Queens-Rocket-Engineering-Team/prop-pandaV2/panda.kicad_pcb

## KiCad design panda.kicad_pcb (2025-11-02)

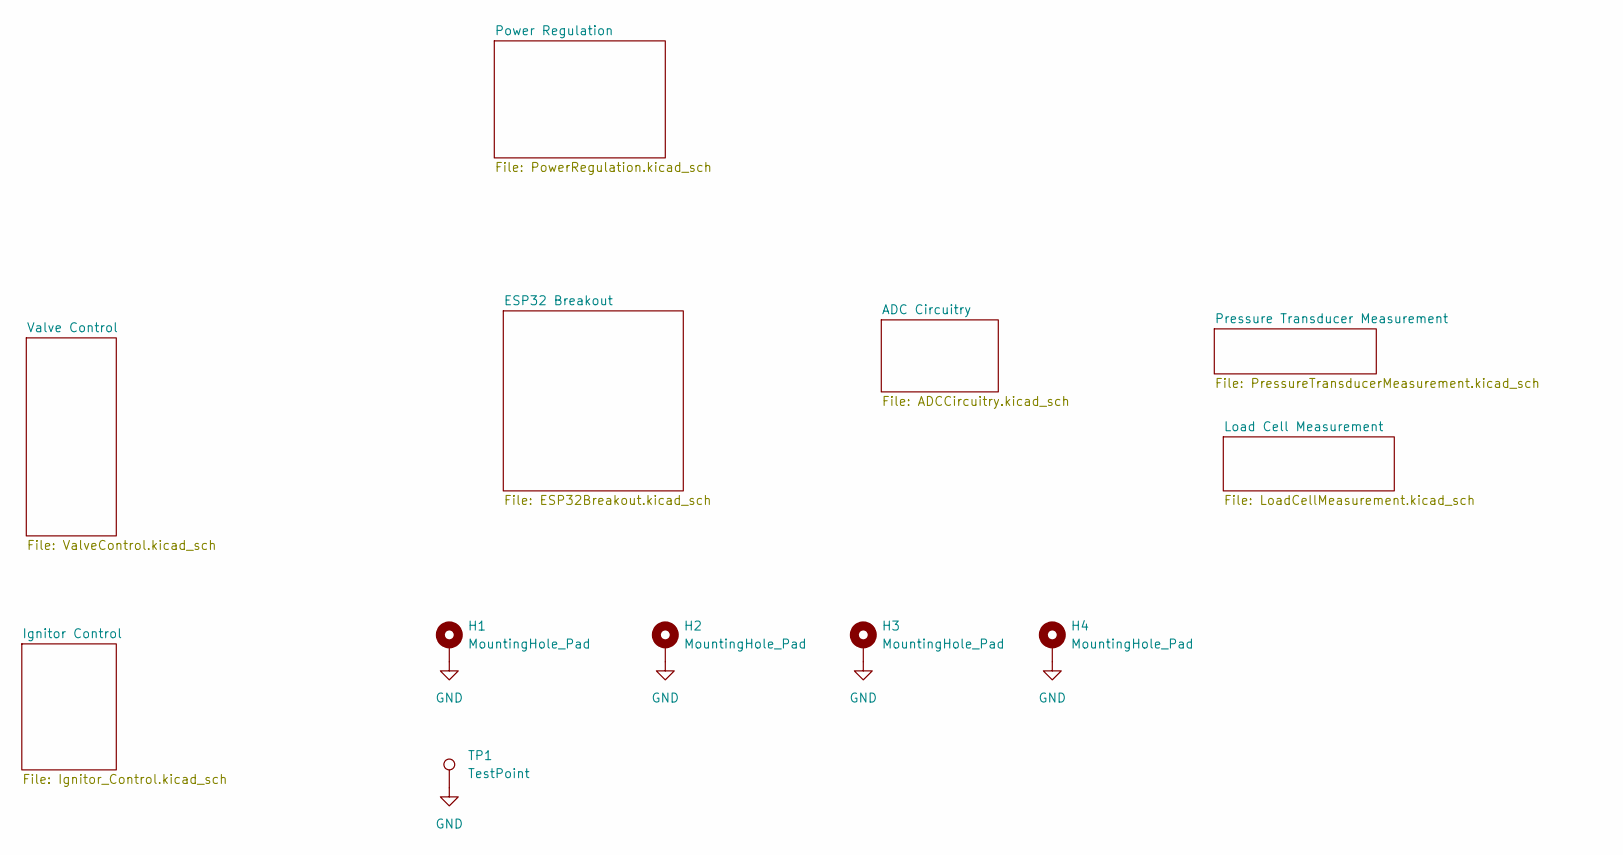
[picture p1: schematic panda.kicad_sch]

Parts:
H1, H2, H3, H4: MountingHole_Pad; MountingHole_3.2mm_M3_ISO7380_Pad
TP1: TestPoint; TestPoint_Loop_D2.50mm_Drill1.0mm

Connections:
GND: H1.1, H2.1, H3.1, H4.1, TP1.1; also elsewhere on the board

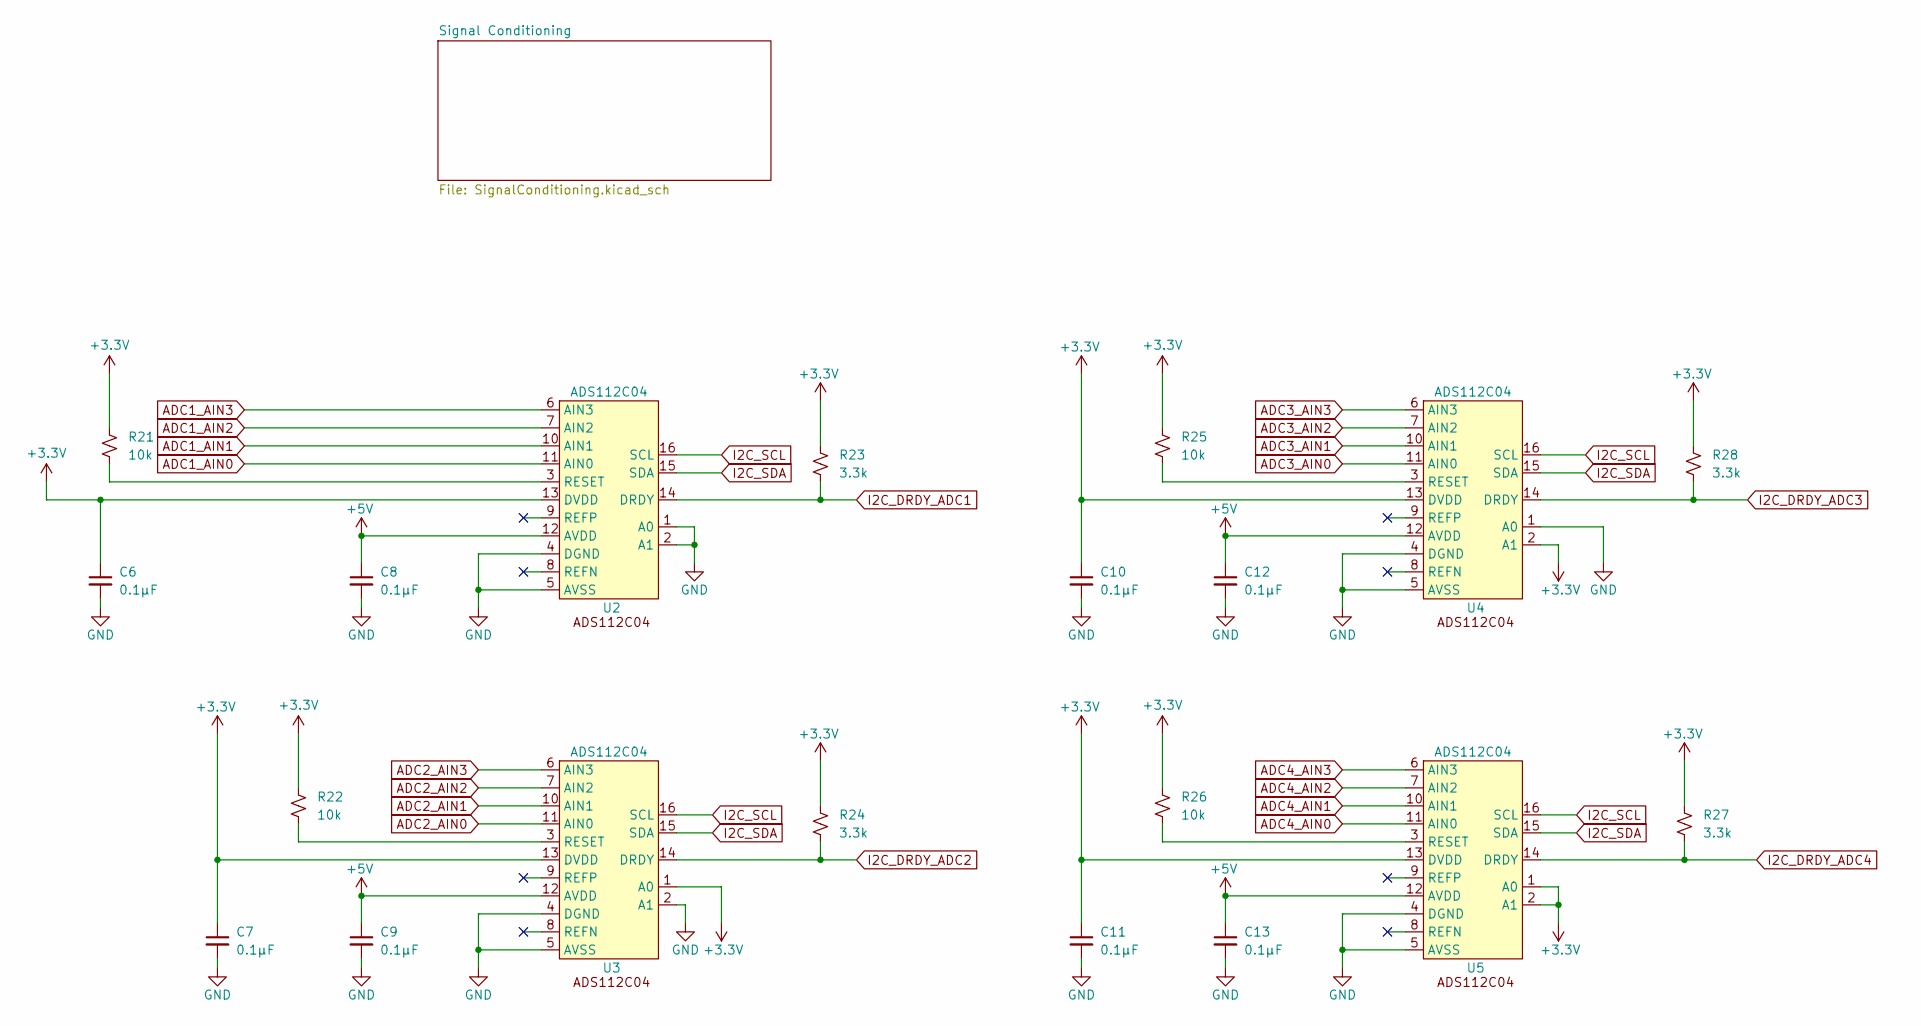
[picture p2: schematic ADCCircuitry.kicad_sch]

Parts:
C6, C7, C8, C9, C10, C11, C12, C13: 0.1μF; C_0402_1005Metric; MPN CL05B104KO5NNNC; LCSC C1525
R21, R22, R25, R26: 10k; R_0402_1005Metric; MPN 0402WGJ0103TCE; LCSC C25531
R23, R24, R27, R28: 3.3k; R_0402_1005Metric; MPN 0402WGF3301TCE; LCSC C25890
U2, U3, U4, U5: ADS112C04; TSSOP-16_4.4x5mm_P0.65mm; MPN ADS112C04IPWR; LCSC C701615

Connections:
+3.3V: C6.1, C7.1, C10.1, C11.1, R21.1, R22.1, R23.1, R24.1, R25.1, R26.1, R27.1, R28.1, U2.13 (DVDD), U3.1 (A0), U3.13 (DVDD), U4.2 (A1), U4.13 (DVDD), U5.1 (A0), U5.2 (A1), U5.13 (DVDD); also elsewhere on the board
+5V: C8.1, C9.1, C12.1, C13.1, U2.12 (AVDD), U3.12 (AVDD), U4.12 (AVDD), U5.12 (AVDD); also elsewhere on the board
ADC1_AIN0: U2.11 (AIN0); also elsewhere on the board
ADC1_AIN1: U2.10 (AIN1); also elsewhere on the board
ADC1_AIN2: U2.7 (AIN2); also elsewhere on the board
ADC1_AIN3: U2.6 (AIN3); also elsewhere on the board
ADC2_AIN0: U3.11 (AIN0); also elsewhere on the board
ADC2_AIN1: U3.10 (AIN1); also elsewhere on the board
ADC2_AIN2: U3.7 (AIN2); also elsewhere on the board
ADC2_AIN3: U3.6 (AIN3); also elsewhere on the board
ADC3_AIN0: U4.11 (AIN0); also elsewhere on the board
ADC3_AIN1: U4.10 (AIN1); also elsewhere on the board
ADC3_AIN2: U4.7 (AIN2); also elsewhere on the board
ADC3_AIN3: U4.6 (AIN3); also elsewhere on the board
ADC4_AIN0: U5.11 (AIN0); also elsewhere on the board
ADC4_AIN1: U5.10 (AIN1); also elsewhere on the board
ADC4_AIN2: U5.7 (AIN2); also elsewhere on the board
ADC4_AIN3: U5.6 (AIN3); also elsewhere on the board
GND: C6.2, C7.2, C8.2, C9.2, C10.2, C11.2, C12.2, C13.2, U2.1 (A0), U2.2 (A1), U2.4 (DGND), U2.5 (AVSS), U3.2 (A1), U3.4 (DGND), U3.5 (AVSS), U4.1 (A0), U4.4 (DGND), U4.5 (AVSS), U5.4 (DGND), U5.5 (AVSS); also elsewhere on the board
I2C_DRDY_ADC1: R23.2, U2.14 (DRDY); also elsewhere on the board
I2C_DRDY_ADC2: R24.2, U3.14 (DRDY); also elsewhere on the board
I2C_DRDY_ADC3: R28.2, U4.14 (DRDY); also elsewhere on the board
I2C_DRDY_ADC4: R27.2, U5.14 (DRDY); also elsewhere on the board
I2C_SCL: U2.16 (SCL), U3.16 (SCL), U4.16 (SCL), U5.16 (SCL); also elsewhere on the board
I2C_SDA: U2.15 (SDA), U3.15 (SDA), U4.15 (SDA), U5.15 (SDA); also elsewhere on the board
unnamed: R21.2, U2.3 (RESET)
unnamed: R22.2, U3.3 (RESET)
unnamed: R25.2, U4.3 (RESET)
unnamed: R26.2, U5.3 (RESET)

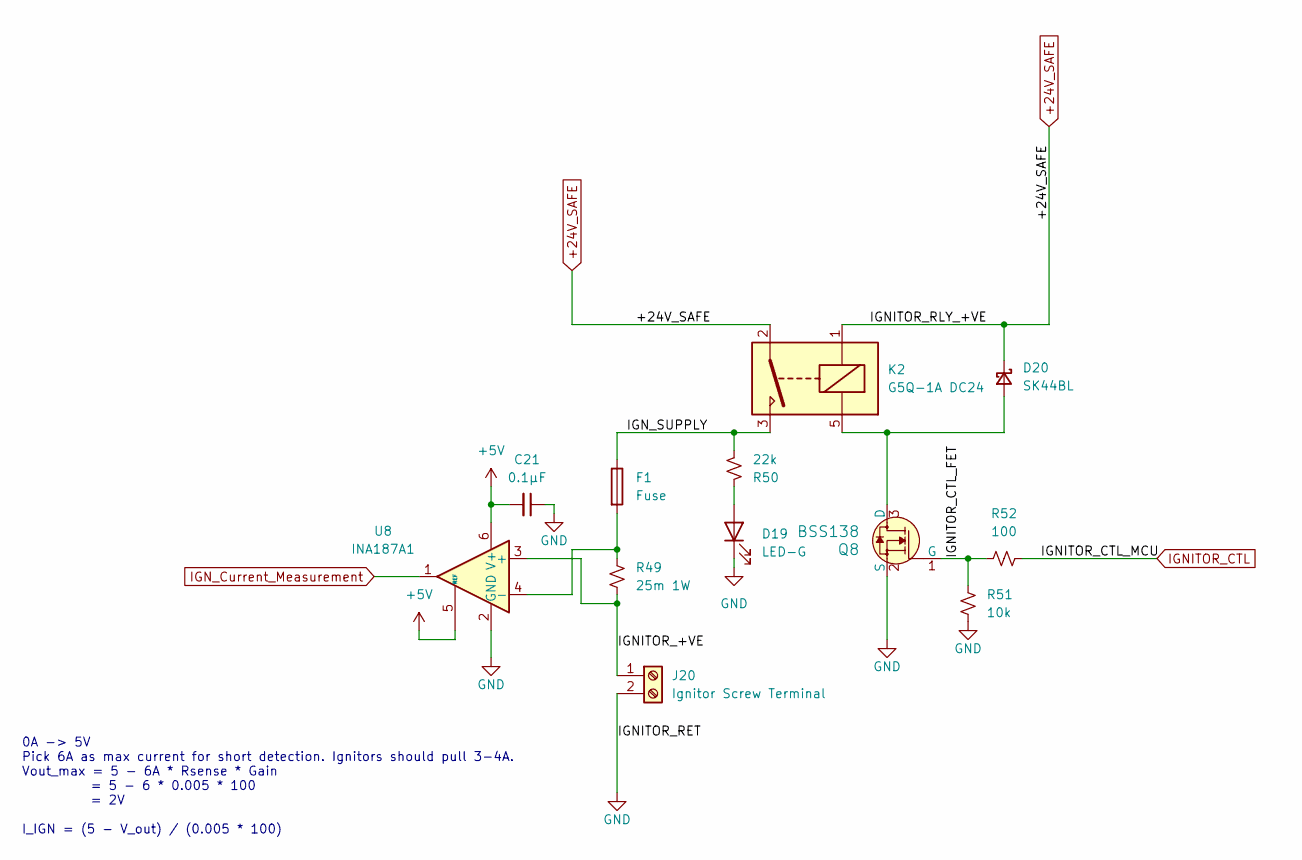
[picture p3: schematic Ignitor_Control.kicad_sch, Ignitor Control]

Parts:
C21: 0.1μF; C_0402_1005Metric; MPN CL05B104KO5NNNC; LCSC C1525
D19: LED-G; LED_0805_2012Metric; LCSC C2297
D20: SK44BL; D_SMB; MPN SK44BL-TP; LCSC C151740
F1: Fuse; Fuseholder_Blade_Mini_Keystone_3568
J20: Ignitor Screw Terminal; TerminalBlock_4Ucon_1x02_P3.50mm_Vertical; MPN OSTTE020104; Digikey PN ED2740-ND
K2: G5Q-1A DC24; Relay_SPST_Omron-G5Q-1A
Q8: BSS138; SOT-23-3; MPN BSS138; LCSC C8490
R49: 25m 1W; R_1206_3216Metric; LCSC C723507
R50: 22k; R_0402_1005Metric
R51: 10k; R_0402_1005Metric; MPN 0402WGJ0103TCE; LCSC C25531
R52: 100; R_0402_1005Metric; MPN 0402WGF1000TCE; LCSC C25076
U8: INA187A1; SOT-23-6

Connections:
+5V: C21.2, U8.5 (REF), U8.6 (V+); also elsewhere on the board
+24V_SAFE: D20.1 (K), K2.1, K2.2; also elsewhere on the board
/Ignitor Control/IGNITOR_+VE: J20.1, R49.2, U8.3 (+)
/Ignitor Control/IGNITOR_CTL_FET: Q8.1 (G), R51.1, R52.1
/Ignitor Control/IGN_SUPPLY: F1.1, K2.3, R50.2
GND: C21.1, D19.1 (K), J20.2, Q8.2 (S), R51.2, U8.2 (GND); also elsewhere on the board
IGNITOR_CTL: R52.2; also elsewhere on the board
IGN_Current_Measurement: U8.1; also elsewhere on the board
unnamed: D19.2 (A), R50.1
unnamed: D20.2 (A), K2.5, Q8.3 (D)
unnamed: F1.2, R49.1, U8.4 (-)

Notes on the sheet:
0A -> 5V Pick 6A as max current for short detection. Ignitors should pull 3-4A. Vout_max = 5 - 6A * Rsense * Gain = 5 - 6 * 0.005 * 100 = 2V I_IGN = (5 - V_out) / (0.005 * 100)

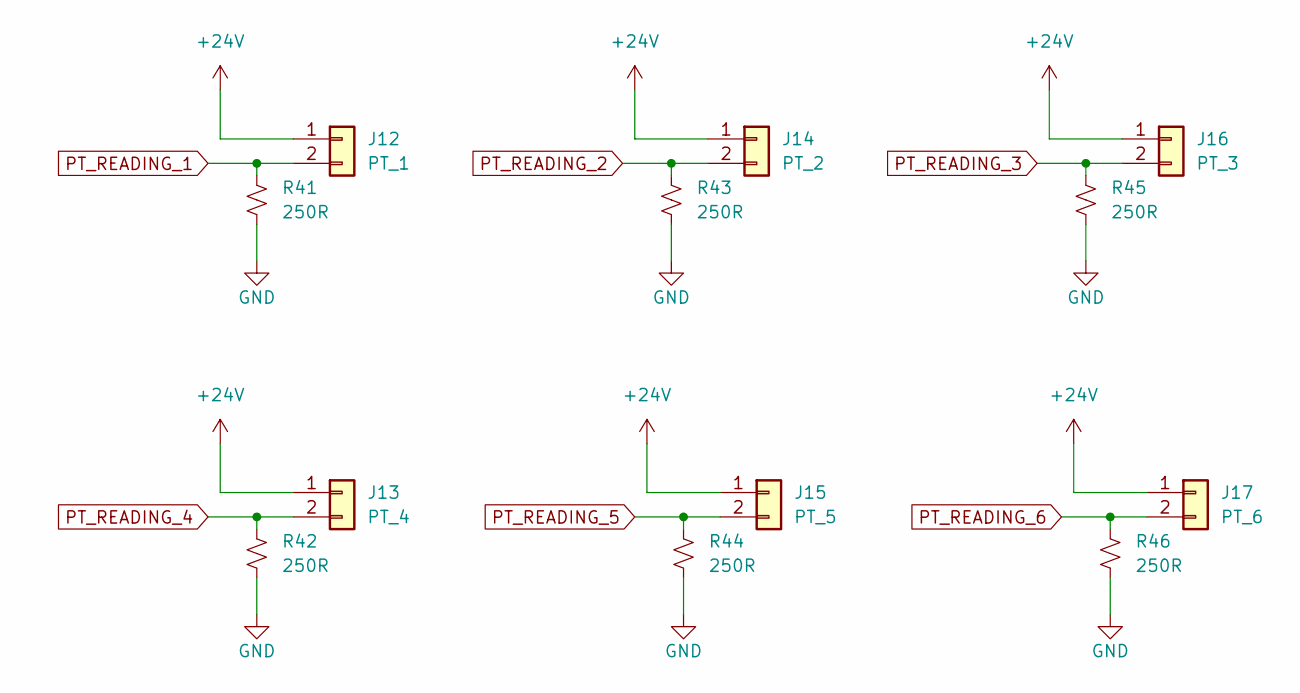
[picture p4: schematic PressureTransducerMeasurement.kicad_sch, Pressure Transducer Measurement]

Parts:
J12: PT_1; JST_XH_B2B-XH-A_1x02_P2.50mm_Vertical; MPN XH-2A; LCSC C20079
J13: PT_4; JST_XH_B2B-XH-A_1x02_P2.50mm_Vertical; MPN XH-2A; LCSC C20079
J14: PT_2; JST_XH_B2B-XH-A_1x02_P2.50mm_Vertical; MPN XH-2A; LCSC C20079
J15: PT_5; JST_XH_B2B-XH-A_1x02_P2.50mm_Vertical; MPN XH-2A; LCSC C20079
J16: PT_3; JST_XH_B2B-XH-A_1x02_P2.50mm_Vertical; MPN XH-2A; LCSC C20079
J17: PT_6; JST_XH_B2B-XH-A_1x02_P2.50mm_Vertical; MPN XH-2A; LCSC C20079
R41, R42, R43, R44, R45, R46: 250R; R_0603_1608Metric; MPN RT0603BRE07250RL; LCSC C861779

Connections:
+24V: J12.1, J13.1, J14.1, J15.1, J16.1, J17.1; also elsewhere on the board
GND: R41.2, R42.2, R43.2, R44.2, R45.2, R46.2; also elsewhere on the board
PT_READING_1: J12.2, R41.1; also elsewhere on the board
PT_READING_2: J14.2, R43.1; also elsewhere on the board
PT_READING_3: J16.2, R45.1; also elsewhere on the board
PT_READING_4: J13.2, R42.1; also elsewhere on the board
PT_READING_5: J15.2, R44.1; also elsewhere on the board
PT_READING_6: J17.2, R46.1; also elsewhere on the board

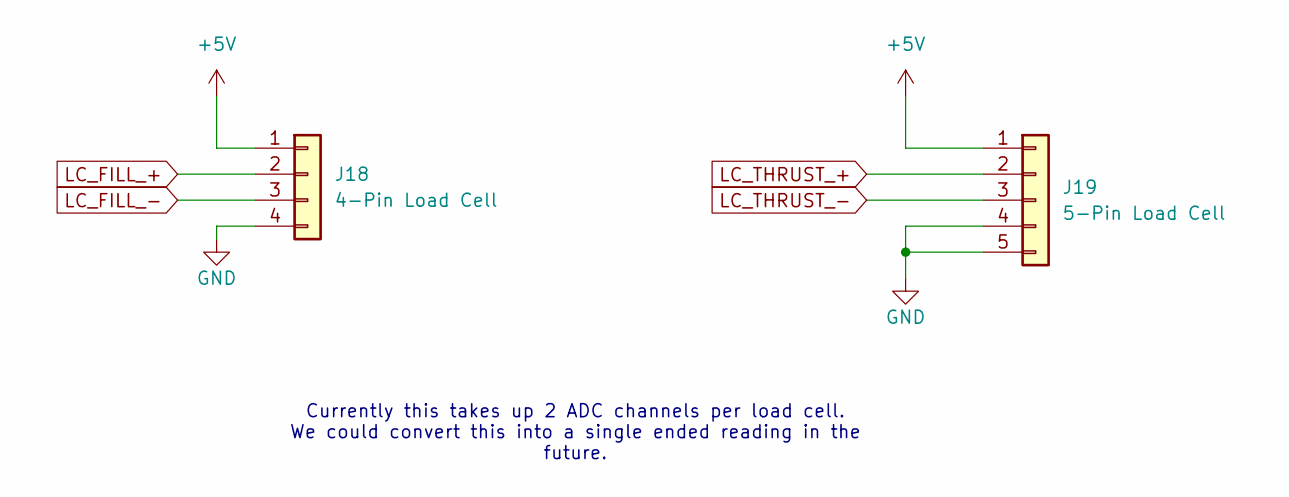
[picture p5: schematic LoadCellMeasurement.kicad_sch, Load Cell Measurement]

Parts:
J18: 4-Pin Load Cell; JST_XH_B4B-XH-A_1x04_P2.50mm_Vertical
J19: 5-Pin Load Cell; JST_XH_B5B-XH-A_1x05_P2.50mm_Vertical

Connections:
+5V: J18.1, J19.1; also elsewhere on the board
GND: J18.4, J19.4, J19.5; also elsewhere on the board
LC_FILL_+: J18.2; also elsewhere on the board
LC_FILL_-: J18.3; also elsewhere on the board
LC_THRUST_+: J19.2; also elsewhere on the board
LC_THRUST_-: J19.3; also elsewhere on the board

Notes on the sheet:
Currently this takes up 2 ADC channels per load cell. We could convert this into a single ended reading in the future.

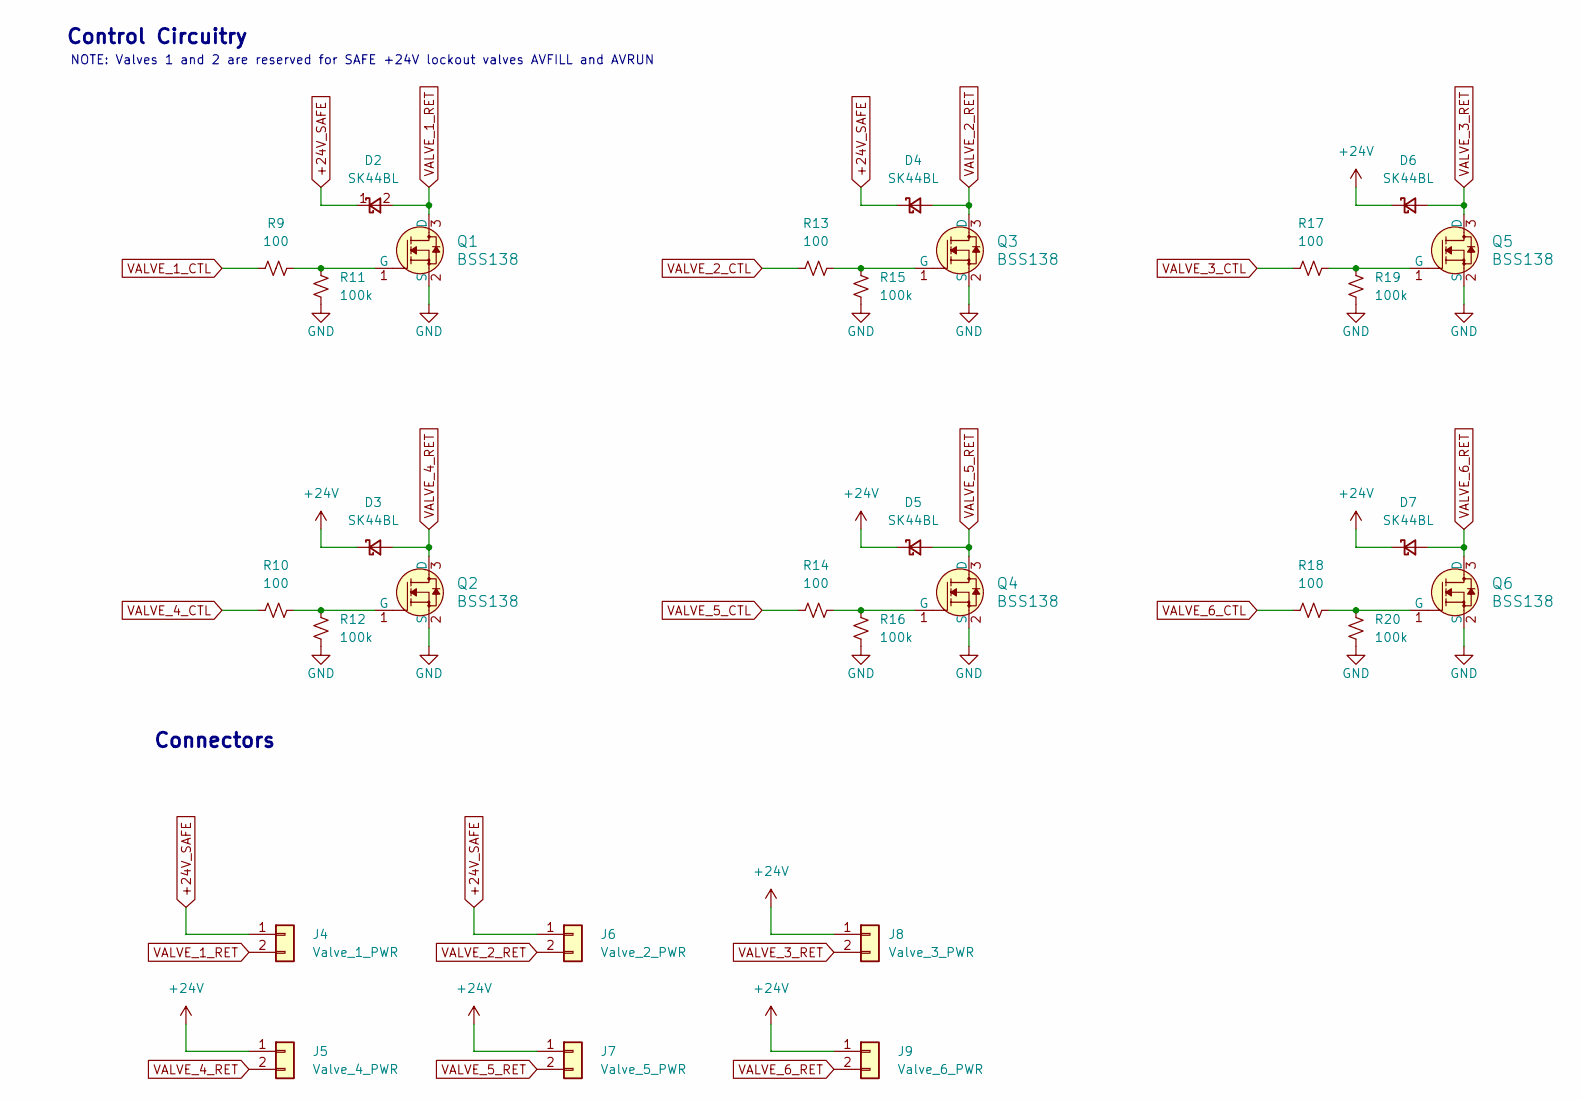
[picture p6: schematic ValveControl.kicad_sch, Valve Control]

Parts:
D2, D3, D4, D5, D6, D7: SK44BL; D_SMB; MPN SK44BL-TP; LCSC C151740
J4: Valve_1_PWR; JST_XH_B2B-XH-A_1x02_P2.50mm_Vertical; MPN XH-2A; LCSC C20079
J5: Valve_4_PWR; JST_XH_B2B-XH-A_1x02_P2.50mm_Vertical; MPN XH-2A; LCSC C20079
J6: Valve_2_PWR; JST_XH_B2B-XH-A_1x02_P2.50mm_Vertical; MPN XH-2A; LCSC C20079
J7: Valve_5_PWR; JST_XH_B2B-XH-A_1x02_P2.50mm_Vertical; MPN XH-2A; LCSC C20079
J8: Valve_3_PWR; JST_XH_B2B-XH-A_1x02_P2.50mm_Vertical; MPN XH-2A; LCSC C20079
J9: Valve_6_PWR; JST_XH_B2B-XH-A_1x02_P2.50mm_Vertical; MPN XH-2A; LCSC C20079
Q1, Q2, Q3, Q4: BSS138; SOT-23-3; MPN BSS138; LCSC C8490
Q5, Q6: BSS138; SOT-23-3; MPN BSS138; Digi-Key_PN BSS138CT-ND
R9, R10, R13, R14, R17, R18: 100; R_0402_1005Metric; MPN 0402WGF1000TCE; LCSC C25076
R11, R12, R15, R16, R19, R20: 100k; R_0402_1005Metric; MPN 0402WGJ0104TCE; LCSC C25530

Connections:
+24V: D3.1 (K), D5.1 (K), D6.1 (K), D7.1 (K), J5.1, J7.1, J8.1, J9.1; also elsewhere on the board
+24V_SAFE: D2.1 (K), D4.1 (K), J4.1, J6.1; also elsewhere on the board
GND: Q1.2 (S), Q2.2 (S), Q3.2 (S), Q4.2 (S), Q5.2 (S), Q6.2 (S), R11.2, R12.2, R15.2, R16.2, R19.2, R20.2; also elsewhere on the board
unnamed: Q1.1 (G), R9.2, R11.1
unnamed: Q2.1 (G), R10.2, R12.1
unnamed: Q3.1 (G), R13.2, R15.1
unnamed: Q4.1 (G), R14.2, R16.1
unnamed: Q5.1 (G), R17.2, R19.1
unnamed: Q6.1 (G), R18.2, R20.1
VALVE_1_CTL: R9.1; also elsewhere on the board
VALVE_1_RET: D2.2 (A), J4.2, Q1.3 (D)
VALVE_2_CTL: R13.1; also elsewhere on the board
VALVE_2_RET: D4.2 (A), J6.2, Q3.3 (D)
VALVE_3_CTL: R17.1; also elsewhere on the board
VALVE_3_RET: D6.2 (A), J8.2, Q5.3 (D)
VALVE_4_CTL: R10.1; also elsewhere on the board
VALVE_4_RET: D3.2 (A), J5.2, Q2.3 (D)
VALVE_5_CTL: R14.1; also elsewhere on the board
VALVE_5_RET: D5.2 (A), J7.2, Q4.3 (D)
VALVE_6_CTL: R18.1; also elsewhere on the board
VALVE_6_RET: D7.2 (A), J9.2, Q6.3 (D)

Notes on the sheet:
NOTE: Valves 1 and 2 are reserved for SAFE +24V lockout valves AVFILL and AVRUN
Control Circuitry
Connectors

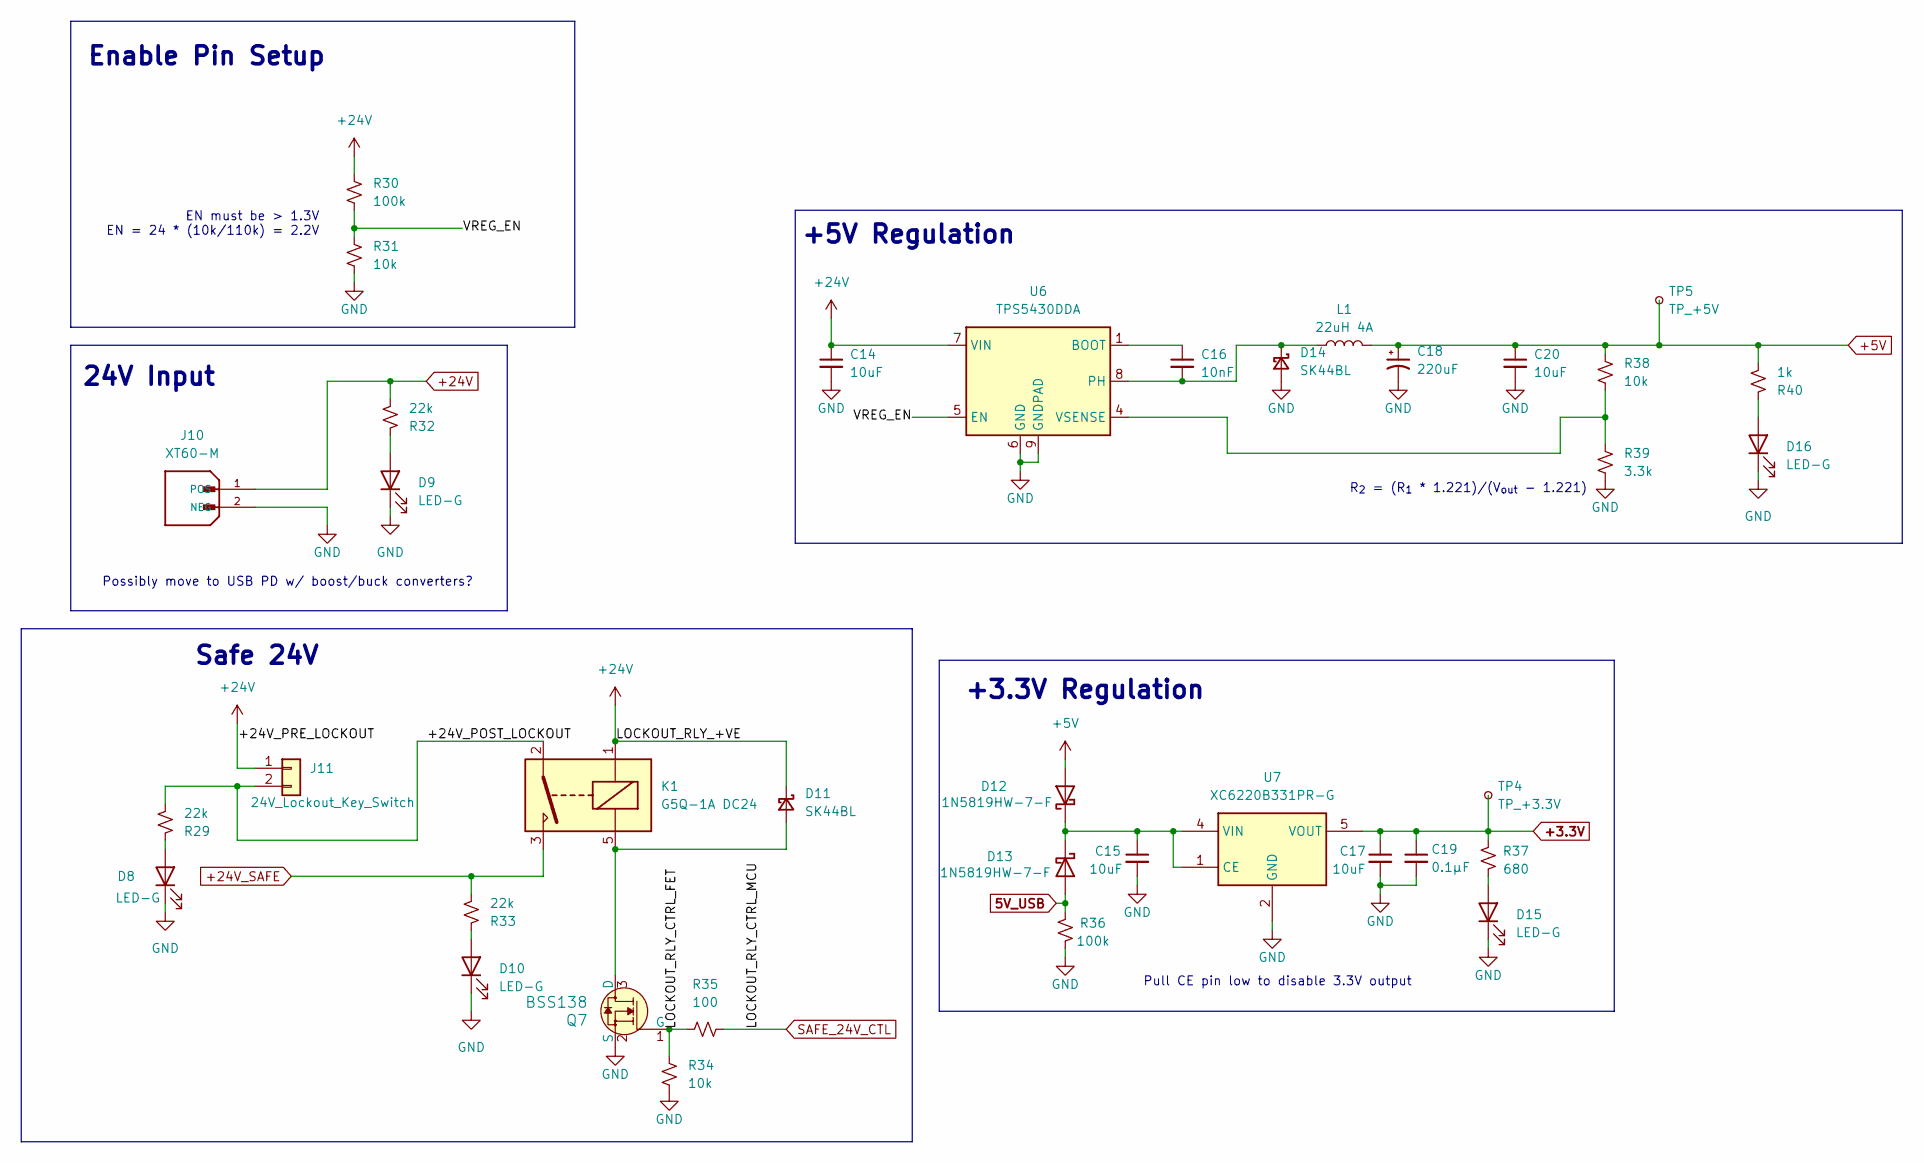
[picture p7: schematic PowerRegulation.kicad_sch, Power Distribution]

Parts:
C14, C15, C17, C20: 10uF; C_1206_3216Metric; Voltage 50V; LCSC C13585
C16: 10nF; C_0402_1005Metric; MPN 0402B103K500NT; LCSC C1524
C18: 220uF; CP_Elec_8x10.5; LCSC C3340
C19: 0.1μF; C_0402_1005Metric; MPN CL05B104KO5NNNC; LCSC C1525
D8, D9, D10, D15, D16: LED-G; LED_0805_2012Metric; LCSC C2297
D11, D14: SK44BL; D_SMB; MPN SK44BL-TP; LCSC C151740
D12, D13: 1N5819HW-7-F; D_SOD-123
J10: XT60-M; AMASS_XT60PW-F_1x02_P7.20mm_Horizontal; PARTREV V1.2
J11: 24V_Lockout_Key_Switch; JST_XH_B2B-XH-A_1x02_P2.50mm_Vertical; MPN XH-2A; LCSC C20079
K1: G5Q-1A DC24; Relay_SPST_Omron-G5Q-1A
L1: 22uH 4A; L_12.5x12.5mm_SXNSMDRS1275; LCSC C163684
Q7: BSS138; SOT-23-3; MPN BSS138; LCSC C8490
R29, R32, R33: 22k; R_0402_1005Metric
R30: 100k; R_0402_1005Metric; MPN 0402WGJ0104TCE; LCSC C25530
R31, R34, R38: 10k; R_0402_1005Metric; MPN 0402WGJ0103TCE; LCSC C25531
R35: 100; R_0402_1005Metric; MPN 0402WGF1000TCE; LCSC C25076
R36: 100k; R_0402_1005Metric
R37: 680; R_0402_1005Metric
R39: 3.3k; R_0402_1005Metric; MPN 0402WGF3301TCE; LCSC C25890
R40: 1k; R_0402_1005Metric
TP4: TP_+3.3V; TestPoint_Pad_D1.0mm
TP5: TP_+5V; TestPoint_Pad_D1.0mm
U6: TPS5430DDA; TI_SO-PowerPAD-8_ThermalVias; LCSC C9864
U7: XC6220B331PR-G; SOT-89-5

Connections:
5V_USB: D13.2 (A), R36.2; also elsewhere on the board
+3.3V: C17.1, C19.1, R37.2, TP4.1, U7.5 (VOUT); also elsewhere on the board
+5V: C18.1, C20.1, D12.2 (A), L1.2, R38.1, R40.2, TP5.1; also elsewhere on the board
+24V: C14.1, D11.1 (K), J10.1 (POS), J11.1, K1.1, R30.1, R32.2, U6.7 (VIN); also elsewhere on the board
+24V_SAFE: K1.3, R33.2; also elsewhere on the board
/Power Regulation/+24V_POST_LOCKOUT: J11.2, K1.2, R29.2
/Power Regulation/LOCKOUT_RLY_CTRL_FET: Q7.1 (G), R34.1, R35.1
/Power Regulation/VREG_EN: R30.2, R31.1, U6.5 (EN)
GND: C14.2, C15.2, C17.2, C18.2, C19.2, C20.2, D8.1 (K), D9.1 (K), D10.1 (K), D14.2 (A), D15.1 (K), D16.1 (K), J10.2 (NEG), Q7.2 (S), R31.2, R34.2, R36.1, R39.2, U6.6 (GND), U6.9 (GNDPAD), U7.2 (GND); also elsewhere on the board
unnamed: D8.2 (A), R29.1
unnamed: D9.2 (A), R32.1
unnamed: D10.2 (A), R33.1
unnamed: D11.2 (A), K1.5, Q7.3 (D)
unnamed: C15.1, D12.1 (K), D13.1 (K), U7.1 (CE), U7.4 (VIN)
unnamed: C16.2, D14.1 (K), L1.1, U6.8 (PH)
unnamed: D15.2 (A), R37.1
unnamed: D16.2 (A), R40.1
unnamed: C16.1, U6.1 (BOOT)
unnamed: R38.2, R39.1, U6.4 (VSENSE)
SAFE_24V_CTL: R35.2; also elsewhere on the board

Notes on the sheet:
EN must be > 1.3V EN = 24 * (10k/110k) = 2.2V
Possibly move to USB PD w/ boost/buck converters?
+5V Regulation
R_{2} = (R_{1} * 1.221)/(V_{out} - 1.221)
+3.3V Regulation
Enable Pin Setup
Pull CE pin low to disable 3.3V output
24V Input
Safe 24V

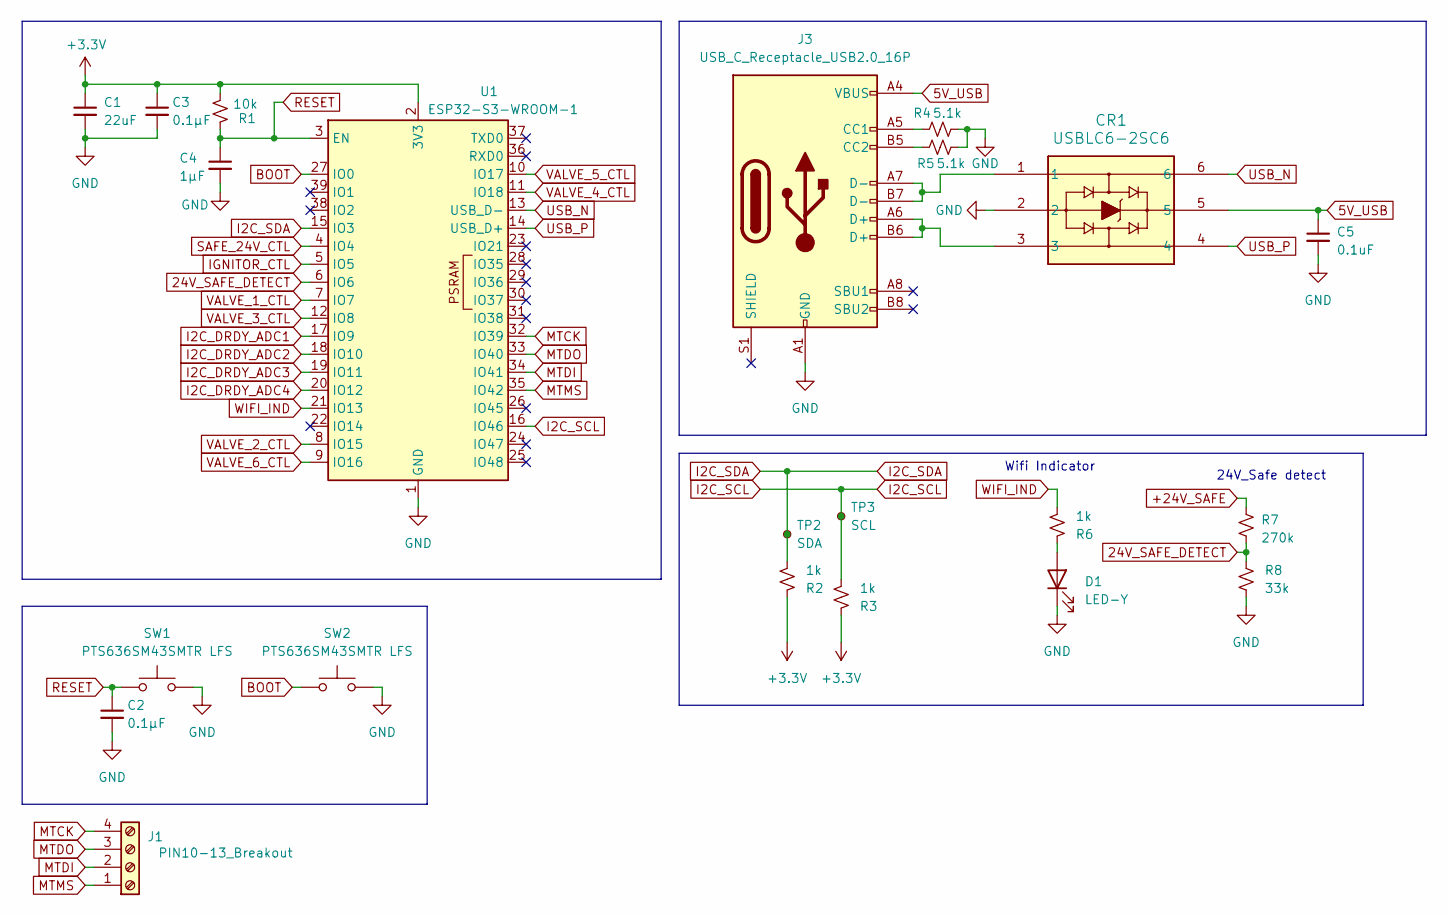
[picture p8: schematic ESP32Breakout.kicad_sch, ESP32 Interface]

Parts:
C1: 22uF; C_1206_3216Metric; Voltage 50V; LCSC C13585
C2, C3: 0.1μF; C_0402_1005Metric; MPN CL05B104KO5NNNC; LCSC C1525
C4: 1μF; C_0402_1005Metric; MPN CL05B104KO5NNNC; LCSC C1525
C5: 0.1uF; C_0402_1005Metric; Voltage 50V; LCSC C13585
CR1: USBLC6-2SC6; SOT-23-6
D1: LED-Y; LED_0805_2012Metric; LCSC C2296
J1: PIN10-13_Breakout; TerminalBlock_Xinya_XY308-2.54-4P_1x04_P2.54mm_Horizontal; Digikey PN ED10563-ND
J3: USB_C_Receptacle_USB2.0_16P; USB_C_Receptacle_HCTL_HC-TYPE-C-16P-01A
R1: 10k; R_0402_1005Metric
R2, R3, R6: 1k; R_0402_1005Metric
R4, R5: 5.1k; R_0402_1005Metric
R7: 270k; R_0402_1005Metric
R8: 33k; R_0402_1005Metric
SW1, SW2: PTS636SM43SMTR LFS; SW_Tactile_SPST_NO_Straight_CK_PTS636Sx25SMTRLFS
TP2: SDA; TestPoint_Pad_D1.5mm
TP3: SCL; TestPoint_Pad_D1.5mm
U1: ESP32-S3-WROOM-1

Connections:
5V_USB: C5.1, CR1.5, J3.A4 (VBUS), J3.A9 (VBUS), J3.B4 (VBUS), J3.B9 (VBUS); also elsewhere on the board
24V_SAFE_DETECT: R7.2, R8.1, U1.6 (IO6)
+3.3V: C1.1, C3.1, R1.2, R2.1, R3.1, U1.2 (3V3); also elsewhere on the board
+24V_SAFE: R7.1; also elsewhere on the board
BOOT: SW2.1, U1.27 (IO0)
GND: C1.2, C2.2, C3.2, C4.2, C5.2, CR1.2, D1.1 (K), J3.A1 (GND), J3.A12 (GND), J3.B1 (GND), J3.B12 (GND), R4.2, R5.2, R8.2, SW1.2, SW2.2, U1.1 (GND), U1.40 (GND), U1.41 (GND); also elsewhere on the board
I2C_DRDY_ADC1: U1.17 (IO9); also elsewhere on the board
I2C_DRDY_ADC2: U1.18 (IO10); also elsewhere on the board
I2C_DRDY_ADC3: U1.19 (IO11); also elsewhere on the board
I2C_DRDY_ADC4: U1.20 (IO12); also elsewhere on the board
I2C_SCL: R3.2, TP3.1, U1.16 (IO46); also elsewhere on the board
I2C_SDA: R2.2, TP2.1, U1.15 (IO3); also elsewhere on the board
IGNITOR_CTL: U1.5 (IO5); also elsewhere on the board
MTCK: J1.4, U1.32 (IO39)
MTDI: J1.2, U1.34 (IO41)
MTDO: J1.3, U1.33 (IO40)
MTMS: J1.1, U1.35 (IO42)
unnamed: CR1.1, J3.A7 (D-), J3.B7 (D-)
unnamed: CR1.3, J3.A6 (D+), J3.B6 (D+)
unnamed: D1.2 (A), R6.1
unnamed: J3.A5 (CC1), R4.1
unnamed: J3.B5 (CC2), R5.1
RESET: C2.1, C4.1, R1.1, SW1.1, U1.3 (EN)
SAFE_24V_CTL: U1.4 (IO4); also elsewhere on the board
USB_N: CR1.6, U1.13 (USB_D-)
USB_P: CR1.4, U1.14 (USB_D+)
VALVE_1_CTL: U1.7 (IO7); also elsewhere on the board
VALVE_2_CTL: U1.8 (IO15); also elsewhere on the board
VALVE_3_CTL: U1.12 (IO8); also elsewhere on the board
VALVE_4_CTL: U1.11 (IO18); also elsewhere on the board
VALVE_5_CTL: U1.10 (IO17); also elsewhere on the board
VALVE_6_CTL: U1.9 (IO16); also elsewhere on the board
WIFI_IND: R6.2, U1.21 (IO13)

Notes on the sheet:
Wifi Indicator
24V_Safe detect

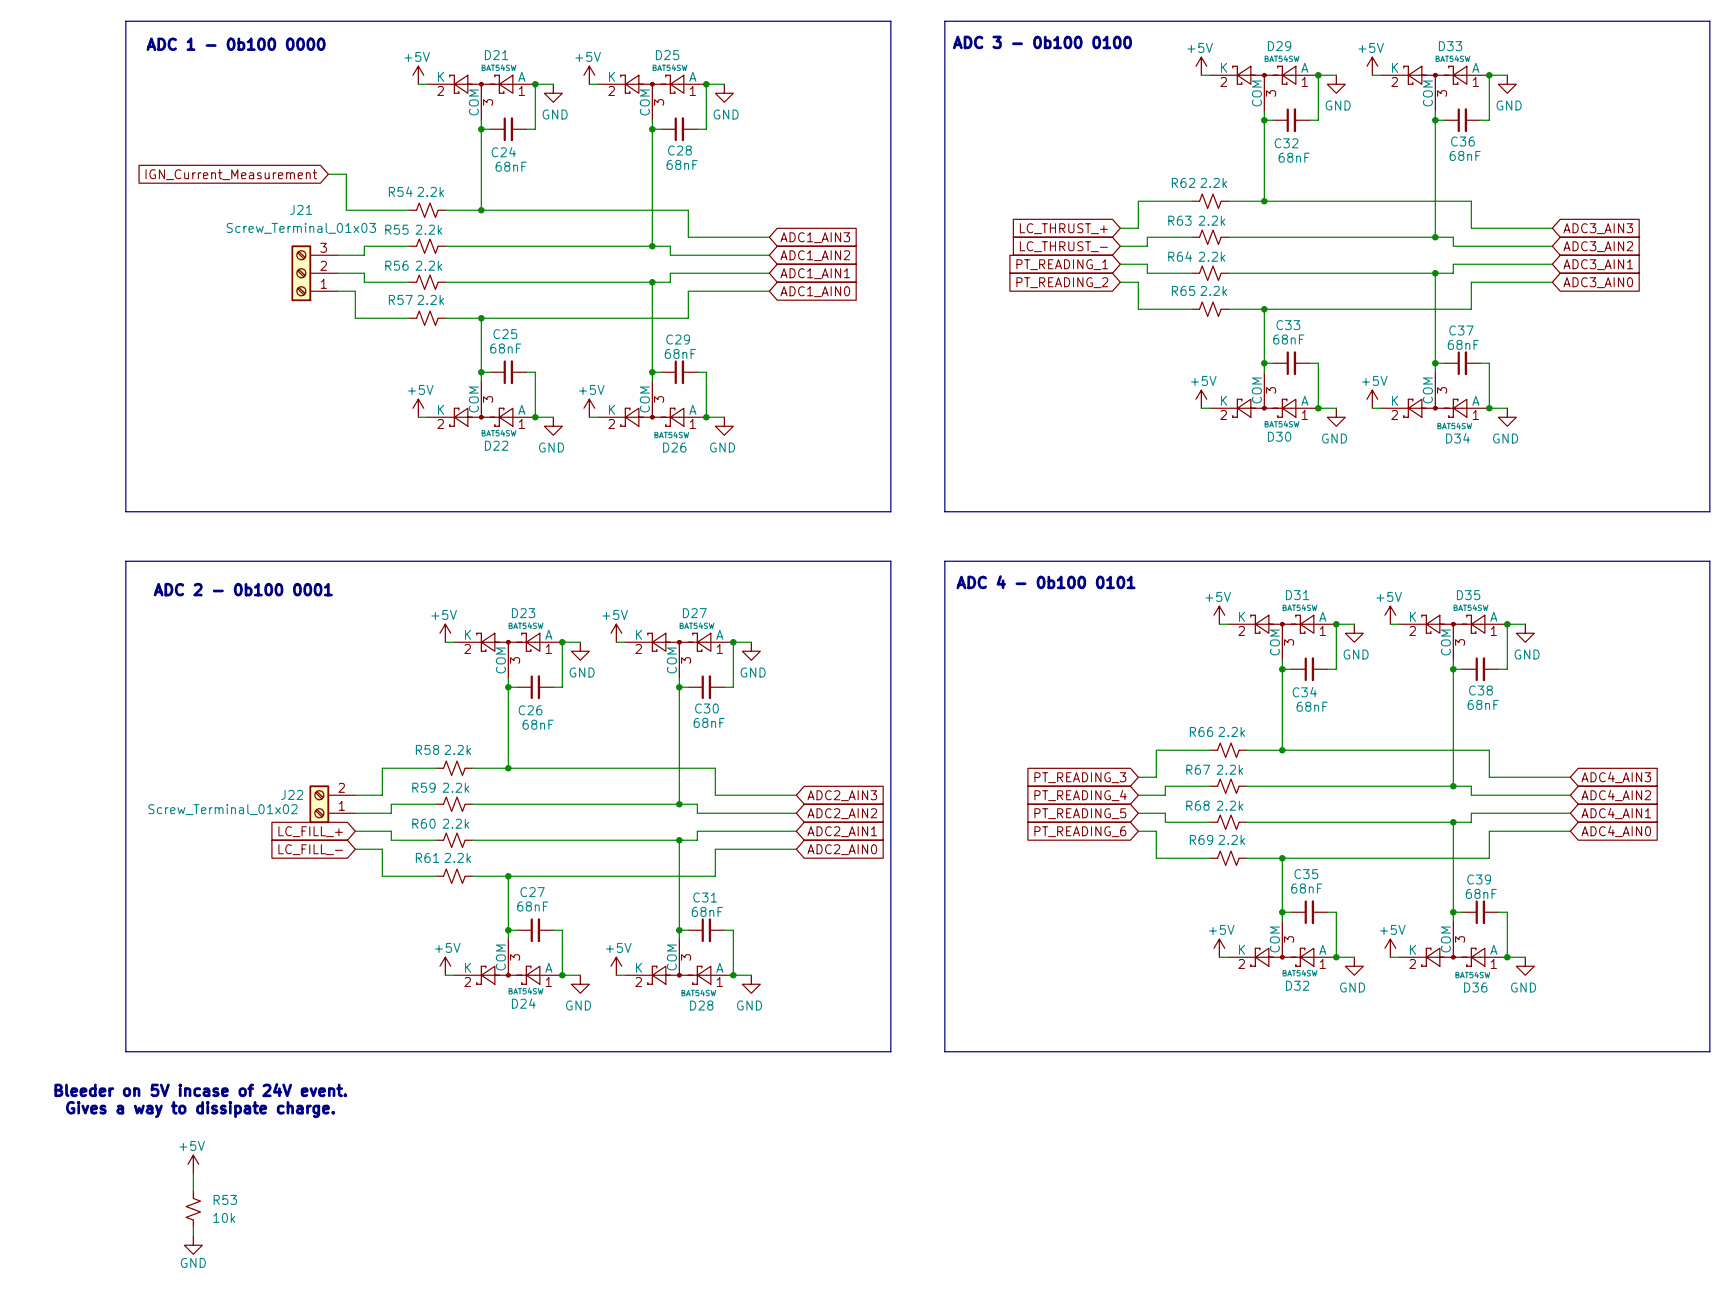
[picture p9: schematic SignalConditioning.kicad_sch]

Parts:
C24, C25, C26, C27, C28, C29, C30, C31, C32, C33, C34, C35, C36, C37, C38, C39: 68nF; C_0805_2012Metric
D21, D22, D23, D24, D25, D26, D27, D28, D29, D30, D31, D32, D33, D34, D35, D36: BAT54SW; SOT-323_SC-70
J21: Screw_Terminal_01x03; TerminalBlock_Xinya_XY308-2.54-3P_1x03_P2.54mm_Horizontal
J22: Screw_Terminal_01x02; TerminalBlock_Xinya_XY308-2.54-2P_1x02_P2.54mm_Horizontal
R53: 10k; R_0402_1005Metric; MPN 0402WGJ0103TCE; LCSC C25531
R54, R55, R56, R57, R58, R59, R60, R61, R62, R63, R64, R65, R66, R67, R68, R69: 2.2k; R_0402_1005Metric

Connections:
+5V: D21.2 (K), D22.2 (K), D23.2 (K), D24.2 (K), D25.2 (K), D26.2 (K), D27.2 (K), D28.2 (K), D29.2 (K), D30.2 (K), D31.2 (K), D32.2 (K), D33.2 (K), D34.2 (K), D35.2 (K), D36.2 (K), R53.1; also elsewhere on the board
ADC1_AIN0: C25.1, D22.3 (COM), R57.2; also elsewhere on the board
ADC1_AIN1: C29.1, D26.3 (COM), R56.2; also elsewhere on the board
ADC1_AIN2: C28.1, D25.3 (COM), R55.2; also elsewhere on the board
ADC1_AIN3: C24.1, D21.3 (COM), R54.2; also elsewhere on the board
ADC2_AIN0: C27.1, D24.3 (COM), R61.2; also elsewhere on the board
ADC2_AIN1: C31.1, D28.3 (COM), R60.2; also elsewhere on the board
ADC2_AIN2: C30.1, D27.3 (COM), R59.2; also elsewhere on the board
ADC2_AIN3: C26.1, D23.3 (COM), R58.2; also elsewhere on the board
ADC3_AIN0: C33.1, D30.3 (COM), R65.2; also elsewhere on the board
ADC3_AIN1: C37.1, D34.3 (COM), R64.2; also elsewhere on the board
ADC3_AIN2: C36.1, D33.3 (COM), R63.2; also elsewhere on the board
ADC3_AIN3: C32.1, D29.3 (COM), R62.2; also elsewhere on the board
ADC4_AIN0: C35.1, D32.3 (COM), R69.2; also elsewhere on the board
ADC4_AIN1: C39.1, D36.3 (COM), R68.2; also elsewhere on the board
ADC4_AIN2: C38.1, D35.3 (COM), R67.2; also elsewhere on the board
ADC4_AIN3: C34.1, D31.3 (COM), R66.2; also elsewhere on the board
GND: C24.2, C25.2, C26.2, C27.2, C28.2, C29.2, C30.2, C31.2, C32.2, C33.2, C34.2, C35.2, C36.2, C37.2, C38.2, C39.2, D21.1 (A), D22.1 (A), D23.1 (A), D24.1 (A), D25.1 (A), D26.1 (A), D27.1 (A), D28.1 (A), D29.1 (A), D30.1 (A), D31.1 (A), D32.1 (A), D33.1 (A), D34.1 (A), D35.1 (A), D36.1 (A), R53.2; also elsewhere on the board
IGN_Current_Measurement: R54.1; also elsewhere on the board
LC_FILL_+: R60.1; also elsewhere on the board
LC_FILL_-: R61.1; also elsewhere on the board
LC_THRUST_+: R62.1; also elsewhere on the board
LC_THRUST_-: R63.1; also elsewhere on the board
unnamed: J21.1, R57.1
unnamed: J21.2, R56.1
unnamed: J21.3, R55.1
unnamed: J22.1, R59.1
unnamed: J22.2, R58.1
PT_READING_1: R64.1; also elsewhere on the board
PT_READING_2: R65.1; also elsewhere on the board
PT_READING_3: R66.1; also elsewhere on the board
PT_READING_4: R67.1; also elsewhere on the board
PT_READING_5: R68.1; also elsewhere on the board
PT_READING_6: R69.1; also elsewhere on the board

Notes on the sheet:
ADC 3 - 0b100 0100
ADC 2 - 0b100 0001
ADC 4 - 0b100 0101
Bleeder on 5V incase of 24V event. Gives a way to dissipate charge.
ADC 1 - 0b100 0000
