Queens-Rocket-Engineering-Team/prop-pandaV2/panda.kicad_pcb

## KiCad design panda.kicad_pcb (continued)

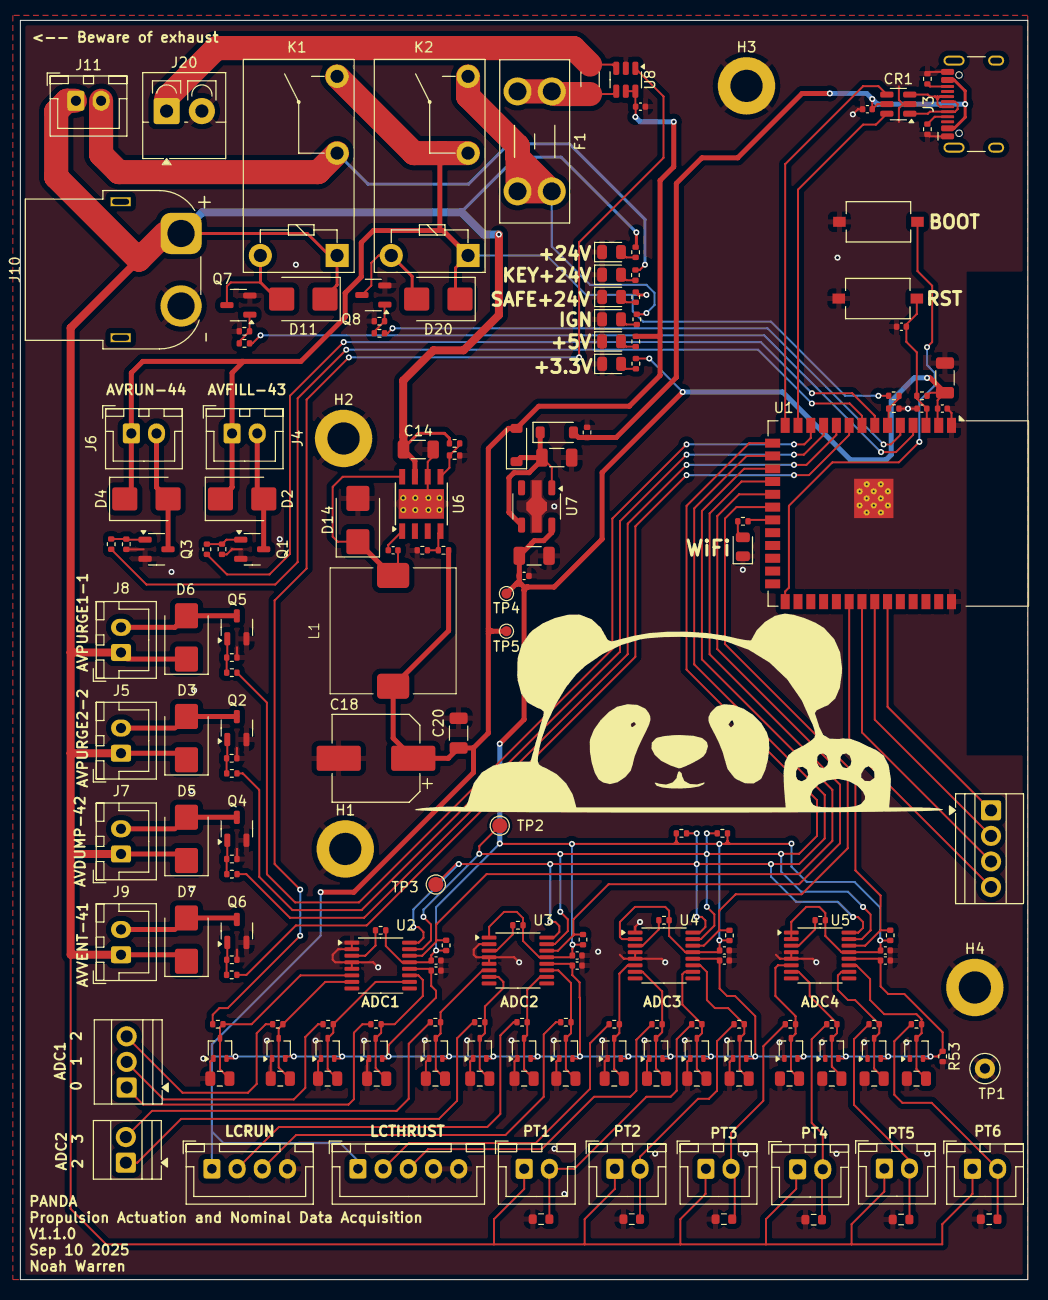
[picture p10: board panda.kicad_pcb from above]

Board: 2 copper layers, 100.0 x 125.0 mm, 191 parts (0 on the bottom side), 102 nets.
