Queens-Rocket-Engineering-Team/prop-pandaV2/(commit log)

2025-07-27 Add power regulation schematic
    [PowerRegulation.kicad_sch, nexus.kicad_sch]
2025-07-27 Add valve control
    [ESP32Breakout.kicad_sch, LoadCellMeasurement.kicad_sch, PowerRegulation.kicad_sch, PressureTransducerMeasurement.kicad_sch, ThermocoupleMeasurement.kicad_sch, nexus.kicad_sch]
2025-07-27 Add SAFE +24V
    [ADCCircuitry.kicad_sch, LoadCellMeasurement.kicad_sch, PressureTransducerMeasurement.kicad_sch, ThermocoupleMeasurement.kicad_sch, ValveControl.kicad_sch]
2025-07-28 Add load cell inputs
    [ADCCircuitry.kicad_sch, ESP32Breakout.kicad_sch, Ignitor_Control.kicad_sch, LoadCellMeasurement.kicad_sch, PowerRegulation.kicad_sch, PressureTransducerMeasurement.kicad_sch, ThermocoupleMeasurement.kicad_sch, ValveControl.kicad_sch]
2025-07-28 v0.1 sch. Add devkit c1 footprint
    [ADCCircuitry.kicad_sch, ESP32Breakout.kicad_sch, LoadCellMeasurement.kicad_sch, PowerRegulation.kicad_sch, PressureTransducerMeasurement.kicad_sch, nexus.kicad_pcb]
2025-07-28 Add all footprints
    [ADCCircuitry.kicad_sch, Ignitor_Control.kicad_sch, PowerRegulation.kicad_sch]
2025-07-29 Almost done routing
    [ADCCircuitry.kicad_sch, ESP32Breakout.kicad_sch, Ignitor_Control.kicad_sch, PowerRegulation.kicad_sch, PressureTransducerMeasurement.kicad_sch, nexus.kicad_pcb]
2025-07-29 Fix J5
    [PowerRegulation.kicad_sch, nexus.kicad_pcb]
2025-07-30 routing broken
    [ADCCircuitry.kicad_sch, ESP32Breakout.kicad_sch, Ignitor_Control.kicad_sch, LoadCellMeasurement.kicad_sch, PowerRegulation.kicad_sch, PressureTransducerMeasurement.kicad_sch, ValveControl.kicad_sch, nexus.kicad_pcb]
2025-07-30 Fix connector references
    [ESP32Breakout.kicad_sch, PowerRegulation.kicad_sch, ValveControl.kicad_sch, nexus.kicad_pcb]
2025-07-30 Route buck converters
    [PowerRegulation.kicad_sch, nexus.kicad_pcb]
2025-07-30 Route first solenoid
    [nexus.kicad_pcb]
2025-07-30 Route All solenoids
    [nexus.kicad_pcb]
2025-07-30 Route I2C lines and ADC communications
    [nexus.kicad_pcb]
2025-07-30 Route power to sensors
    [ADCCircuitry.kicad_sch, nexus.kicad_pcb]
2025-07-30 Satisfy DRC
    [ESP32Breakout.kicad_sch, nexus.kicad_pcb]
2025-07-30 Add Mounting Holes
    [nexus.kicad_pcb]
2025-07-30 Add silk screening
    [nexus.kicad_pcb]
2025-07-30 Update silk screening
    [nexus.kicad_pcb]
2025-07-30 PANDA Rebrand
    [nexus.kicad_pcb]
2025-07-30 Fix inductor layout
    [nexus.kicad_pcb]
2025-07-30 Fix silk screening
    [ADCCircuitry.kicad_sch, ESP32Breakout.kicad_sch, Ignitor_Control.kicad_sch, LoadCellMeasurement.kicad_sch, PowerRegulation.kicad_sch, PressureTransducerMeasurement.kicad_sch, ValveControl.kicad_sch, nexus.kicad_pcb]
2025-07-30 Complete panda rename
    [panda.kicad_pcb, panda.kicad_sch]
2025-07-31 PCB v1.0.0 Ordered
    [panda.kicad_pcb, panda.kicad_sch]
2025-08-27 Switch relay driving FETs to low side. Relays changed to SPST instead of SPDT
    [Ignitor_Control.kicad_sch, PowerRegulation.kicad_sch, panda.kicad_pcb]
2025-08-27 Actually fix XT60 silkscreen and placement
    [panda.kicad_pcb]
2025-08-27 Swap PT3 and PT4 connectors so they are connected to teh proper pins
    [PressureTransducerMeasurement.kicad_sch, panda.kicad_pcb]
2025-08-27 Actually fix PT3 and PT4 mapping
    [ADCCircuitry.kicad_sch, PressureTransducerMeasurement.kicad_sch, panda.kicad_pcb]
2025-08-27 Update thrust LC to take +5V. Remove +10V rail
    [LoadCellMeasurement.kicad_sch, PowerRegulation.kicad_sch, panda.kicad_pcb]
2025-09-07 Add signal conditioning. Change screw hole footprint
    [ADCCircuitry.kicad_sch, SignalConditioning.kicad_sch, panda.kicad_pcb, panda.kicad_sch]
2025-09-07 Update +5V rail wiring for adcs and signal conditioning
    [panda.kicad_pcb]
2025-09-10 Add current sensing and fuse mount for IGN
    [ESP32Breakout.kicad_sch, Ignitor_Control.kicad_sch, SignalConditioning.kicad_sch, panda.kicad_pcb]
2025-09-10 Add indicator LEDs and digital +24VSafe detection line
    [ESP32Breakout.kicad_sch, Ignitor_Control.kicad_sch, PowerRegulation.kicad_sch, panda.kicad_pcb]
2025-09-10 Update version numbers
    [panda.kicad_pcb]
2025-10-07 Completed necessary ESP32 wiring + new 3.3V LDO. GPIO pins not yet connected
    [ESP32Breakout.kicad_sch, PowerRegulation.kicad_sch]
2025-10-09 connected to GPIO pins
    [ADCCircuitry.kicad_sch, ESP32Breakout.kicad_sch, Ignitor_Control.kicad_sch, LoadCellMeasurement.kicad_sch, PowerRegulation.kicad_sch, PressureTransducerMeasurement.kicad_sch, SignalConditioning.kicad_sch, ValveControl.kicad_sch]
2025-10-13 added 24V lockout key LED indicator
    [ESP32Breakout.kicad_sch, Ignitor_Control.kicad_sch, PowerRegulation.kicad_sch, PressureTransducerMeasurement.kicad_sch, SignalConditioning.kicad_sch, panda.kicad_pcb]
2025-10-16 added ignitor current sensor overvoltage protection
    [Ignitor_Control.kicad_sch]
2025-10-17 pcb first draft, changed esp32 pin connections
    [ADCCircuitry.kicad_sch, ESP32Breakout.kicad_sch, Ignitor_Control.kicad_sch, LoadCellMeasurement.kicad_sch, PowerRegulation.kicad_sch, PressureTransducerMeasurement.kicad_sch, SignalConditioning.kicad_sch, ValveControl.kicad_sch]
2025-10-18 replaced ignitor current sensor with INA187A3 for higher voltage tolerance
    [Ignitor_Control.kicad_sch, panda.kicad_pcb]
2025-10-18 fixed 5v rail connection for signal conditioning
    [panda.kicad_pcb]
2025-11-02 changed CSA to INA187A1 from INA187A3 for availability
    [Ignitor_Control.kicad_sch, panda.kicad_pcb]
